OsciX/NumitronClock/Images/FrontSideView.jpg

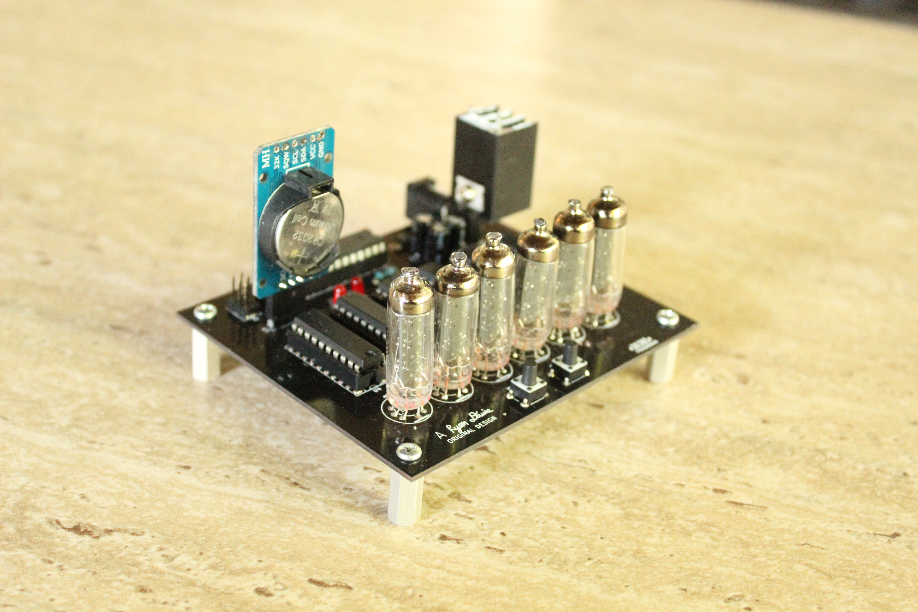
Images/FrontSideView.jpg
