OsciX/NumitronClock/Images/TopView.jpg

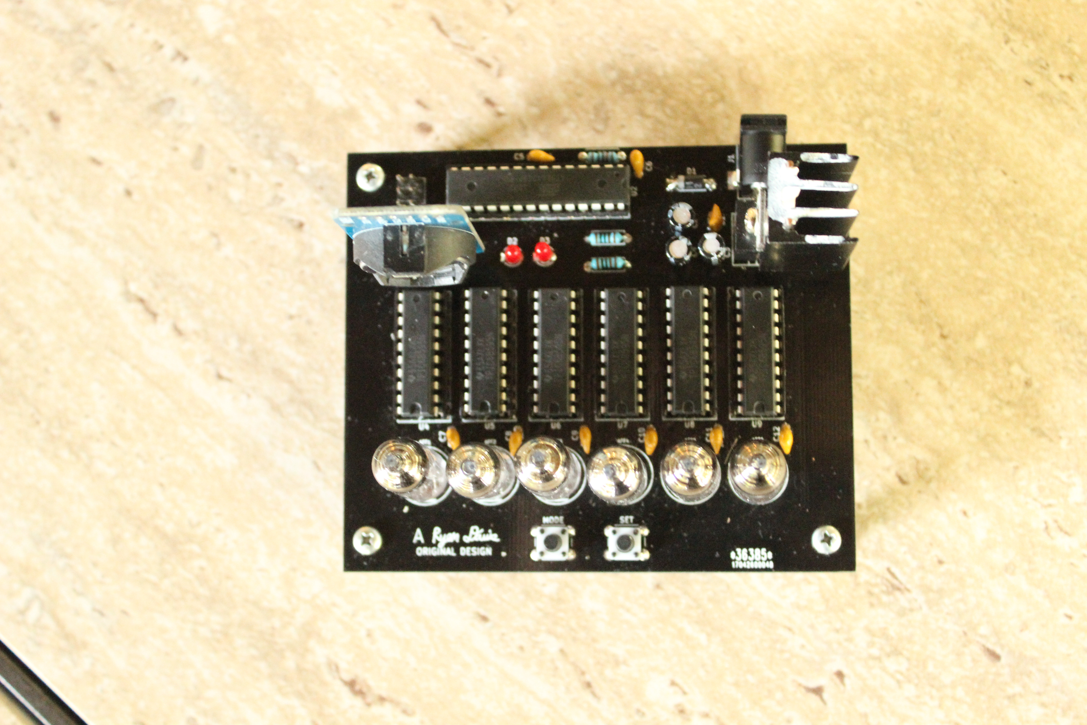
Images/TopView.jpg
