OsciX/NumitronClock/README.md

# NumitronClock
Code repository for my Numitron Clock project.
Requires t3db0t's button library, located at https://github.com/t3db0t/Button, and Adafruit's RTClib from https://github.com/adafruit/RTClib.
