OsciX/NumitronClock/Images/BackView.jpg

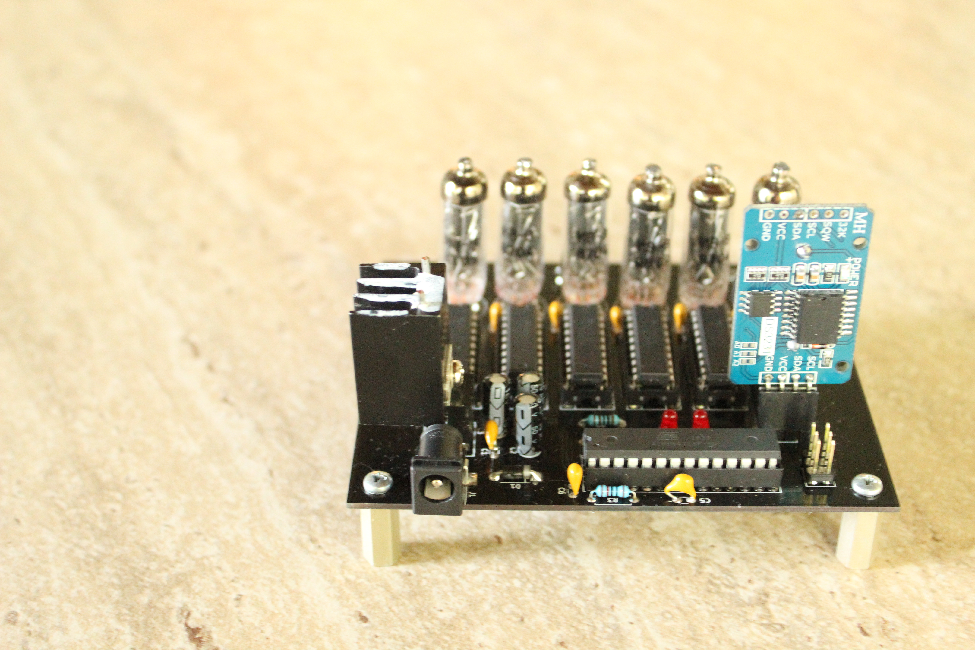
Images/BackView.jpg
