OsciX/NumitronClock/Images/DisplayingTime.jpg

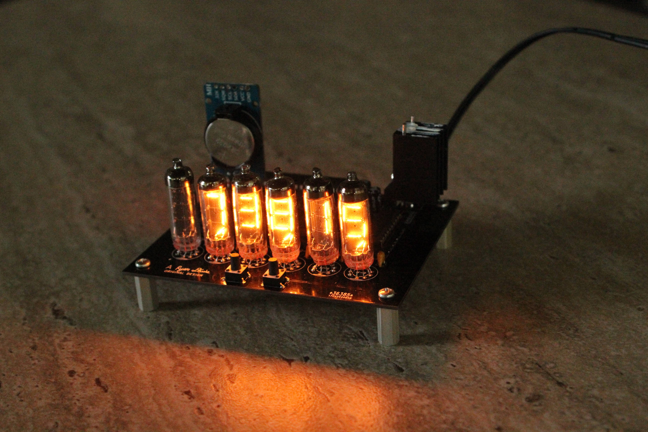
Images/DisplayingTime.jpg
