OsciX/NumitronClock/Hardware/Schematic.pdf

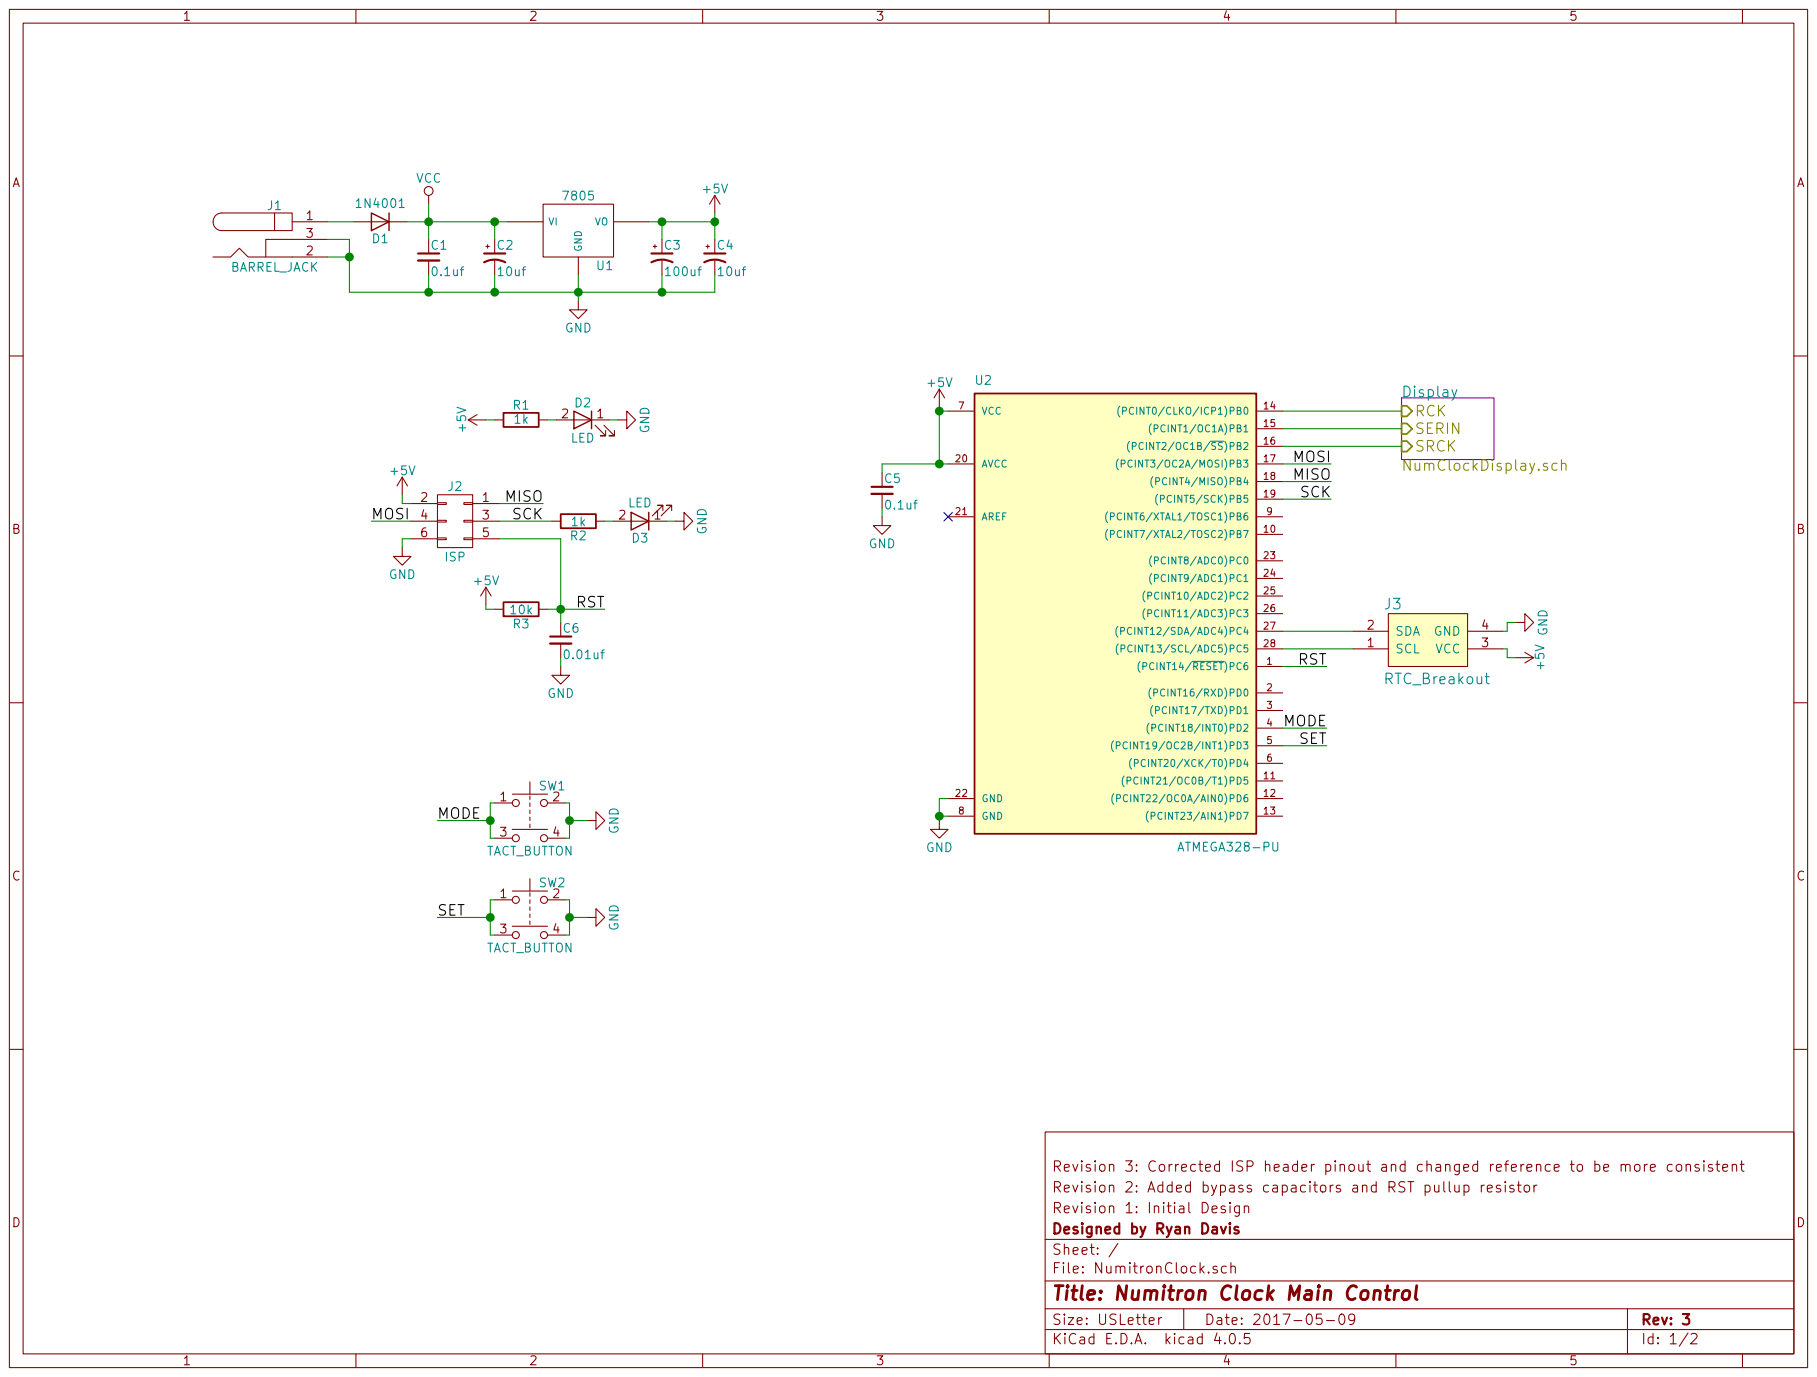
[picture p5: page 1]

Revision 3: Corrected ISP header pinout and changed reference to be more consistent
Revision 2: Added bypass capacitors and RST pullup resistor
Revision 1: Initial Design
Id: 1/2 Title: Numitron Clock Main Control File: NumitronClock.sch Sheet: / Designed by Ryan Davis

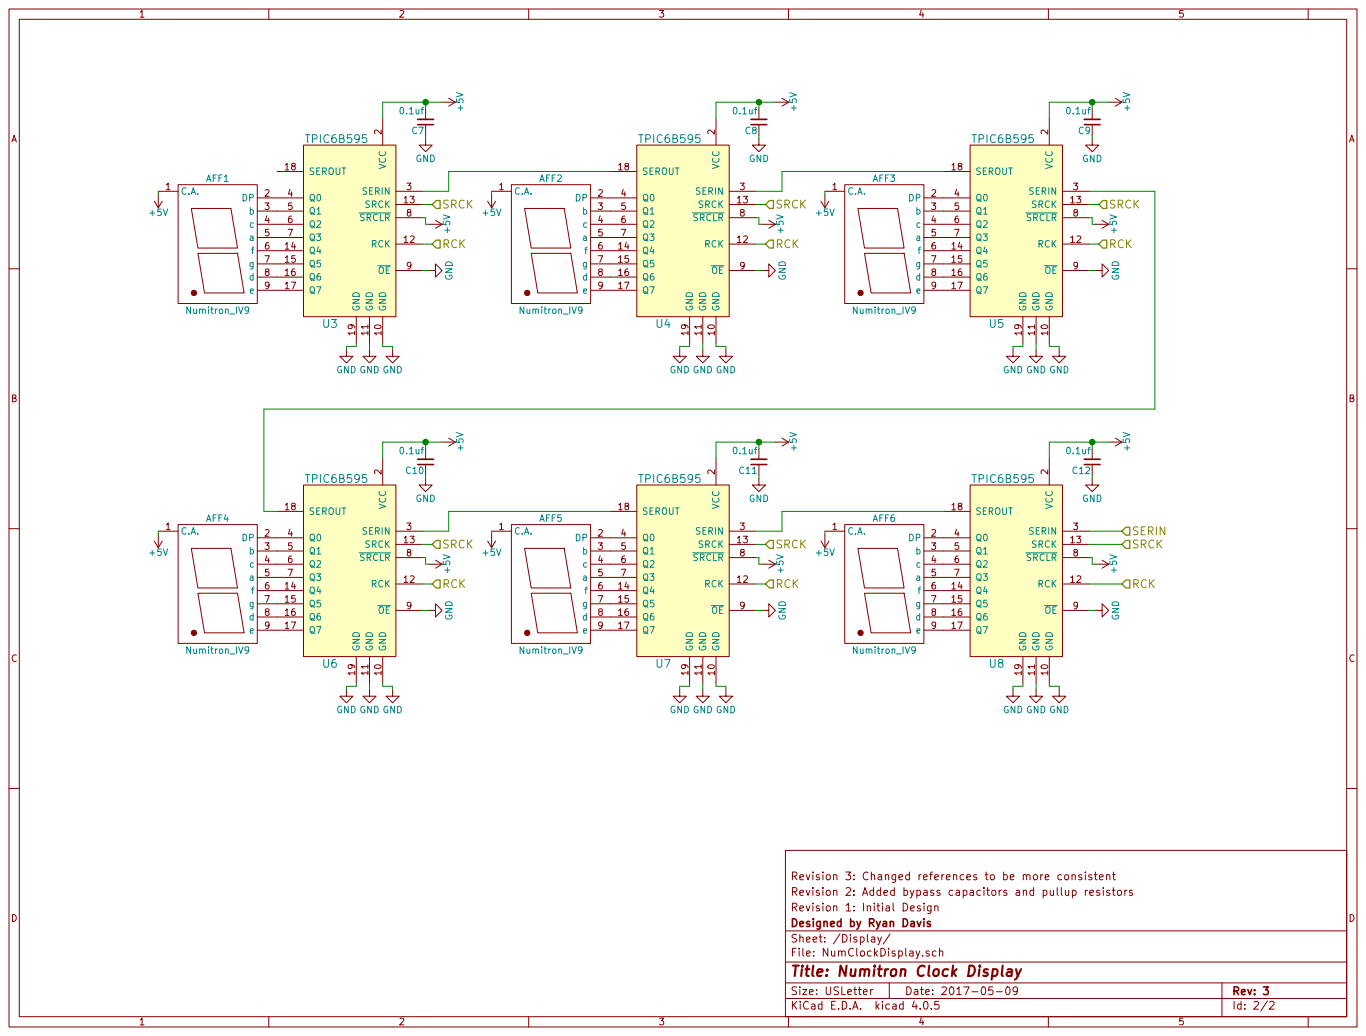
[picture p6: page 2]

2 SERIN 3 Q0 4 Q1 5 Q2 6 Q3 7 SRCLR 8 OE 9 GND 10 GND 11 RCK 12 SRCK 13 Q4 14 Q5 15 Q6 16 Q7 17 SEROUT 18 GND 19U3 TPIC6B595 C.A. 1 DP 2

2 SERIN 3 Q0 4 Q1 5 Q2 6 Q3 7 SRCLR 8 OE 9 GND 10 GND 11 RCK 12 SRCK 13 Q4 14 Q5 15 Q6 16 Q7 17 SEROUT 18 GND 19U4 TPIC6B595 C.A. 1 DP 2

2 SERIN 3 Q0 4 Q1 5 Q2 6 Q3 7 SRCLR 8 OE 9 GND 10 GND 11 RCK 12 SRCK 13 Q4 14 Q5 15 Q6 16 Q7 17 SEROUT 18 GND 19U5 TPIC6B595 C.A. 1 DP 2

2 SERIN 3 Q0 4 Q1 5 Q2 6 Q3 7 SRCLR 8 OE 9 GND 10 GND 11 RCK 12 SRCK 13 Q4 14 Q5 15 Q6 16 Q7 17 SEROUT 18 GND 19U6 TPIC6B595 C.A. 1 DP 2

2 SERIN 3 Q0 4 Q1 5 Q2 6 Q3 7 SRCLR 8 OE 9 GND 10 GND 11 RCK 12 SRCK 13 Q4 14 Q5 15 Q6 16 Q7 17 SEROUT 18 GND 19U7 TPIC6B595 C.A. 1 DP 2

2 SERIN 3 Q0 4 Q1 5 Q2 6 Q3 7 SRCLR 8 OE 9 GND 10 GND 11 RCK 12 SRCK 13 Q4 14 Q5 15 Q6 16 Q7 17 SEROUT 18 GND 19U8 TPIC6B595 C.A. 1 DP 2

Revision 3: Changed references to be more consistentVCC

Revision 2: Added bypass capacitors and pullup resistors
Revision 1: Initial Design
Designed by Ryan Davis
Sheet: /Display/
File: NumClockDisplay.sch
Id: 2/2 Title: Numitron Clock Display
