OsciX/NumitronClock/Hardware/Design Files/NumitronClock.kicad_pcb

## KiCad design Hardware/Design Files/NumitronClock.kicad_pcb (2017-10-06)

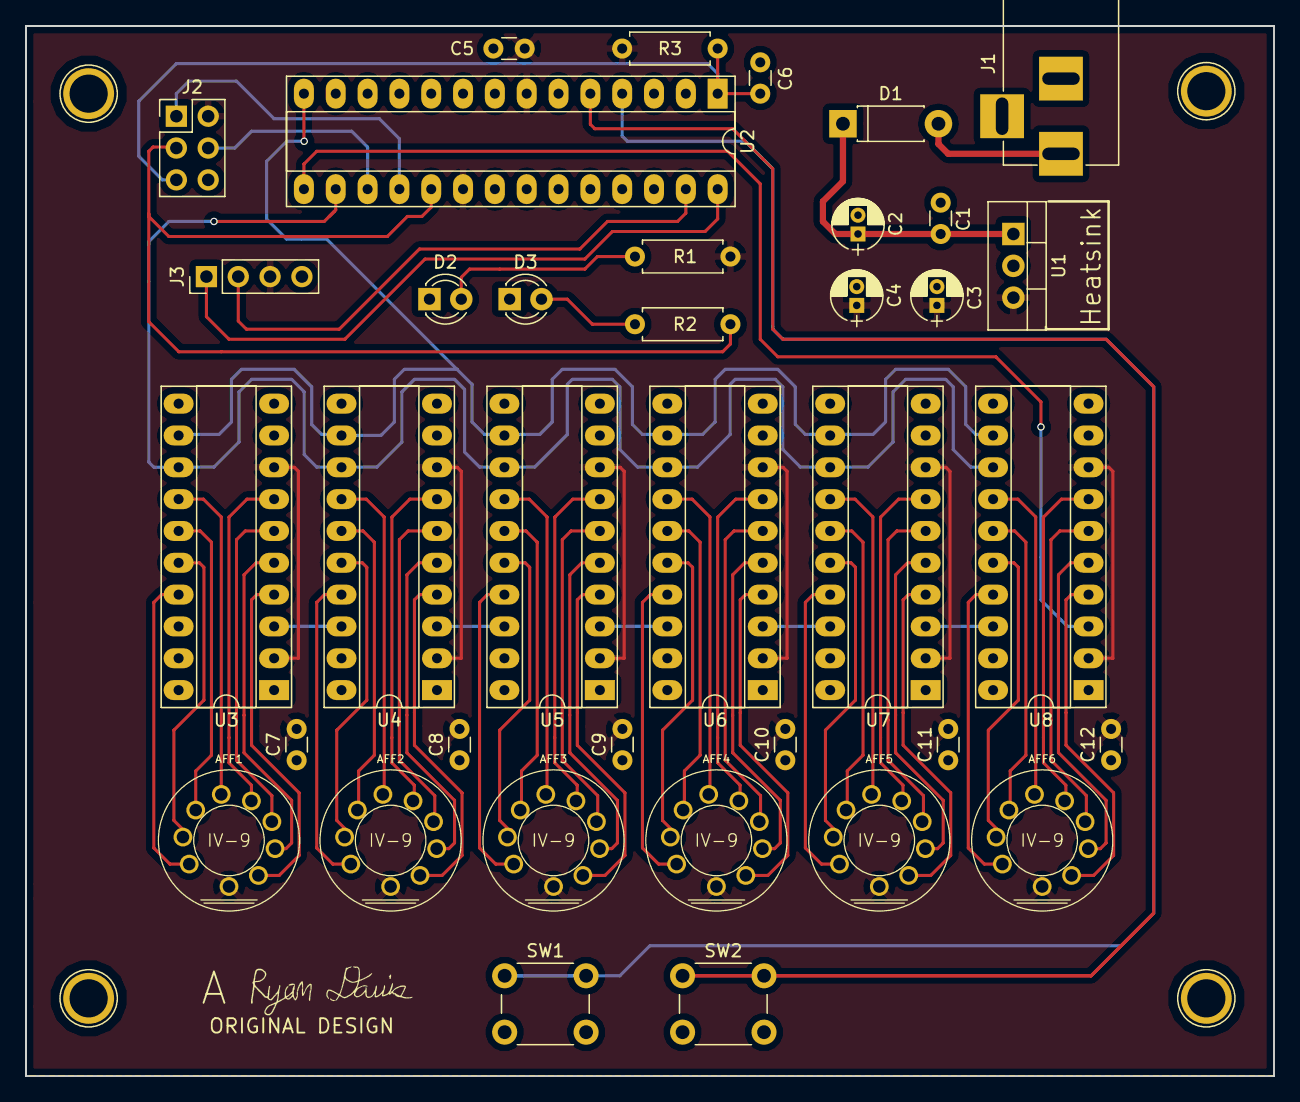
[picture p11: board NumitronClock.kicad_pcb from above]

Board: 2 copper layers, 99.6 x 83.8 mm, 37 parts (0 on the bottom side), 70 nets.

Parts:
AFF1, AFF2, AFF3, AFF4, AFF5, AFF6: Numitron_IV9; NUM_IV-9
C1, C5, C7, C8, C9, C10, C11, C12: 0.1uf; C_Disc_D3.0mm_W1.6mm_P2.50mm
C2, C4: 10uf; CP_Radial_D4.0mm_P1.50mm
C3: 100uf; CP_Radial_D4.0mm_P1.50mm
C6: 0.01uf; C_Disc_D3.0mm_W1.6mm_P2.50mm
D1: 1N4001; D_DO-41_SOD81_P7.62mm_Horizontal
D2, D3: LED; LED_D3.0mm
J1: BARREL_JACK
J2: ISP; Pin_Header_Straight_2x03_Pitch2.54mm
J3: RTC_Breakout; Pin_Header_Straight_1x04_Pitch2.54mm
R1, R2: 1k; R_Axial_DIN0207_L6.3mm_D2.5mm_P7.62mm_Horizontal
R3: 10k; R_Axial_DIN0207_L6.3mm_D2.5mm_P7.62mm_Horizontal
SW1, SW2: TACT_BUTTON; SW_PUSH_6mm
U1: 7805; TO-220_Vertical
U2: ATMEGA328-PU; DIP-28_W7.62mm_Socket_LongPads
U3, U4, U5, U6, U7, U8: TPIC6B595; DIP-20_W7.62mm_Socket_LongPads

Connections:
+5V: AFF1.1, AFF2.1, AFF3.1, AFF4.1, AFF5.1, AFF6.1, C3.1, C4.1, C5.1, C7.2, C8.2, C9.2, C10.2, C11.2, C12.2, J2.2, J3.3, R1.2, R3.2, U1.3, U2.7, U2.20, U3.2, U3.8, U4.2, U4.8, U5.2, U5.8, U6.2, U6.8, U7.2, U7.8, U8.2, U8.8
/Display/RCK: U2.14, U3.12, U4.12, U5.12, U6.12, U7.12, U8.12
/Display/SERIN: U2.15, U8.3
/Display/SRCK: U2.16, U3.13, U4.13, U5.13, U6.13, U7.13, U8.13
/MISO: J2.1, U2.18
/MODE: SW1.1, U2.4
/MOSI: J2.4, U2.17
/RST: C6.1, J2.5, R3.1, U2.1
/SCK: J2.3, R2.2, U2.19
/SET: SW2.1, U2.5
GND: C1.2, C2.2, C3.2, C4.2, C5.2, C6.2, C7.1, C8.1, C9.1, C10.1, C11.1, C12.1, D2.1, D3.1, J1.2, J1.3, J2.6, J3.4, SW1.2, SW2.2, U1.2, U2.8, U2.22, U3.9, U3.10, U3.11, U3.19, U4.9, U4.10, U4.11, U4.19, U5.9, U5.10, U5.11, U5.19, U6.9, U6.10, U6.11, U6.19, U7.9, U7.10, U7.11, U7.19, U8.9, U8.10, U8.11, U8.19
unnamed: AFF1.2, U3.4
unnamed: AFF1.3, U3.5
unnamed: AFF1.4, U3.6
unnamed: AFF1.5, U3.7
unnamed: AFF1.6, U3.14
unnamed: AFF1.7, U3.15
unnamed: AFF1.8, U3.16
unnamed: AFF1.9, U3.17
unnamed: AFF2.2, U4.4
unnamed: AFF2.3, U4.5
unnamed: AFF2.4, U4.6
unnamed: AFF2.5, U4.7
unnamed: AFF2.6, U4.14
unnamed: AFF2.7, U4.15
unnamed: AFF2.8, U4.16
unnamed: AFF2.9, U4.17
unnamed: AFF3.2, U5.4
unnamed: AFF3.3, U5.5
unnamed: AFF3.4, U5.6
unnamed: AFF3.5, U5.7
unnamed: AFF3.6, U5.14
unnamed: AFF3.7, U5.15
unnamed: AFF3.8, U5.16
unnamed: AFF3.9, U5.17
unnamed: AFF4.2, U6.4
unnamed: AFF4.3, U6.5
unnamed: AFF4.4, U6.6
unnamed: AFF4.5, U6.7
unnamed: AFF4.6, U6.14
unnamed: AFF4.7, U6.15
unnamed: AFF4.8, U6.16
unnamed: AFF4.9, U6.17
unnamed: AFF5.2, U7.4
unnamed: AFF5.3, U7.5
unnamed: AFF5.4, U7.6
unnamed: AFF5.5, U7.7
unnamed: AFF5.6, U7.14
unnamed: AFF5.7, U7.15
unnamed: AFF5.8, U7.16
unnamed: AFF5.9, U7.17
unnamed: AFF6.2, U8.4
unnamed: AFF6.3, U8.5
unnamed: AFF6.4, U8.6
unnamed: AFF6.5, U8.7
unnamed: AFF6.6, U8.14
unnamed: AFF6.7, U8.15
unnamed: AFF6.8, U8.16
unnamed: AFF6.9, U8.17
unnamed: D1.2, J1.1
unnamed: D2.2, R1.1
unnamed: D3.2, R2.1
unnamed: J3.1, U2.28
unnamed: J3.2, U2.27
unnamed: U3.3, U4.18
unnamed: U4.3, U5.18
unnamed: U5.3, U6.18
unnamed: U6.3, U7.18
unnamed: U7.3, U8.18
VCC: C1.1, C2.1, D1.1, U1.1
