OsciX/NumitronClock/(commit log)

2017-04-10 Add working code
    Add .ino files for Arduino code, and update README to include
    dependencies.
2017-10-06 Add circuit board design files
    [NumClockDisplay.sch, NumitronClock.kicad_pcb, NumitronClock.sch]
